p0dxD/espWatchOS/3dmodel/bme280.png

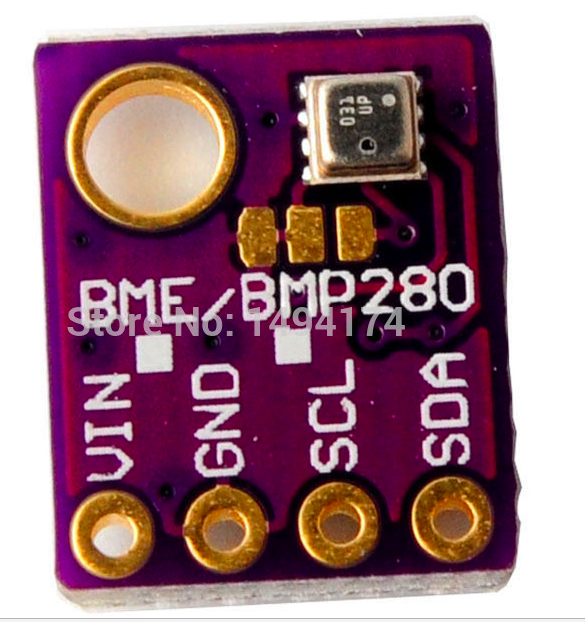
3dmodel/bme280.png
