p0dxD/espWatchOS/3dmodel/eink.png

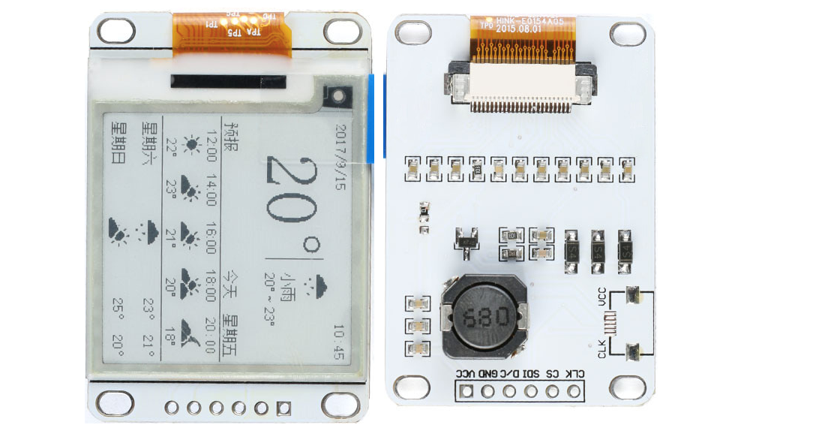
3dmodel/eink.png
