p0dxD/espWatchOS/3dmodel/eink_back.png

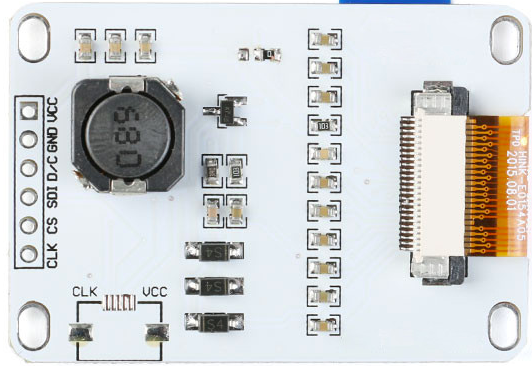
3dmodel/eink_back.png
