p0dxD/espWatchOS/3dmodel/eink_front.png

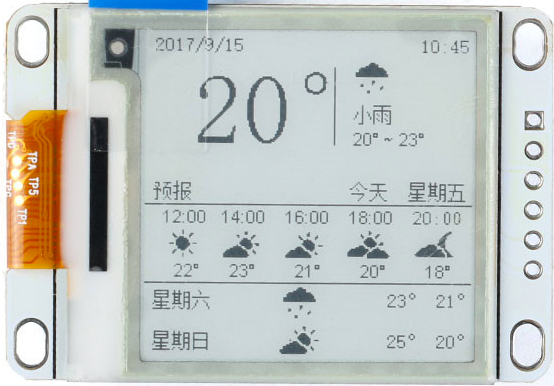
3dmodel/eink_front.png
