p0dxD/espWatchOS/3dmodel/esp.png

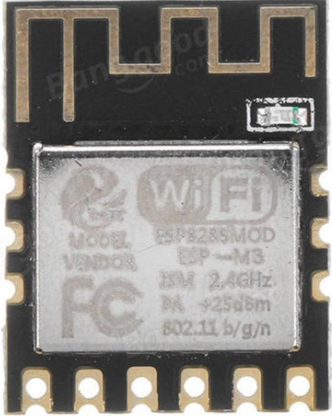
3dmodel/esp.png
