p0dxD/espWatchOS/code/assets/face.bmp

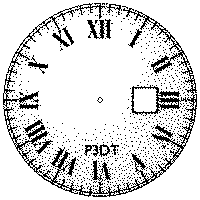
code/assets/face.bmp
