p0dxD/espWatchOS/code/assets/face.png

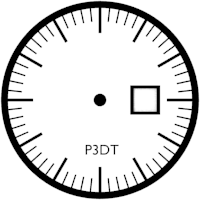
code/assets/face.png
