p0dxD/espWatchOS/3dmodel/wristband-15cm.stl

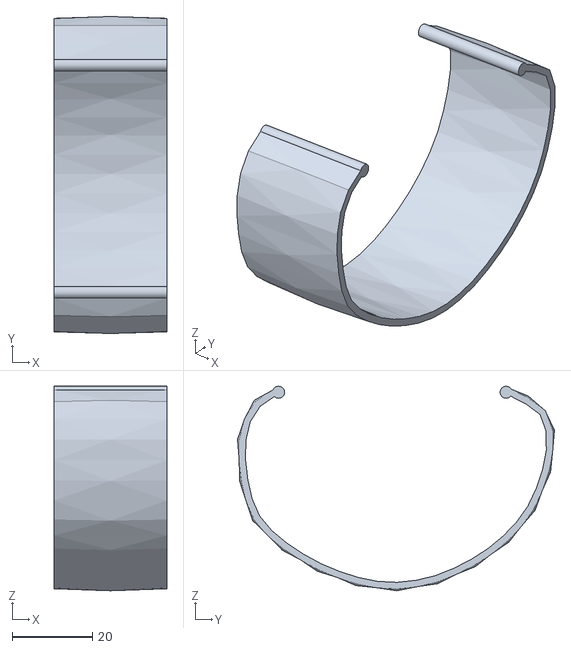
[picture p13: CAD file, 2018-08-28]
3dmodel/wristband-15cm.stl
28.0 x 78.8 x 50.9
