p0dxD/espWatchOS/3dmodel/espWatch-v4.stl

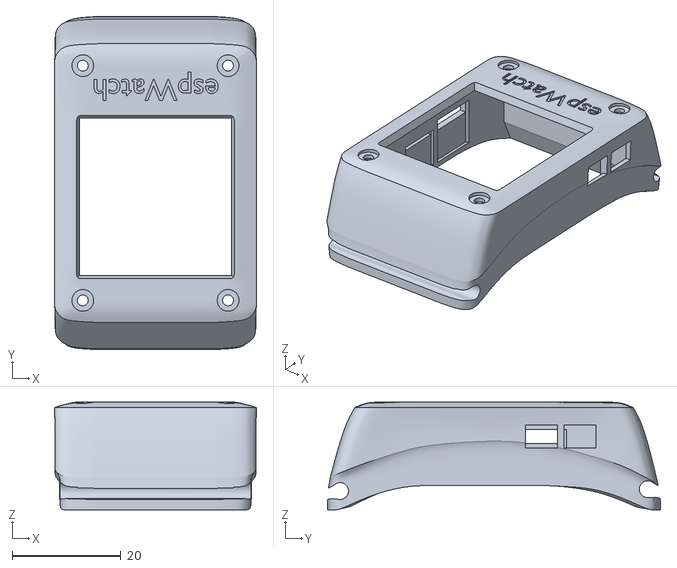
[picture p14: CAD file, 2018-08-28]
3dmodel/espWatch-v4.stl
37.2 x 61.2 x 19.8
