p0dxD/espWatchOS/3dmodel/bottom cover.stl

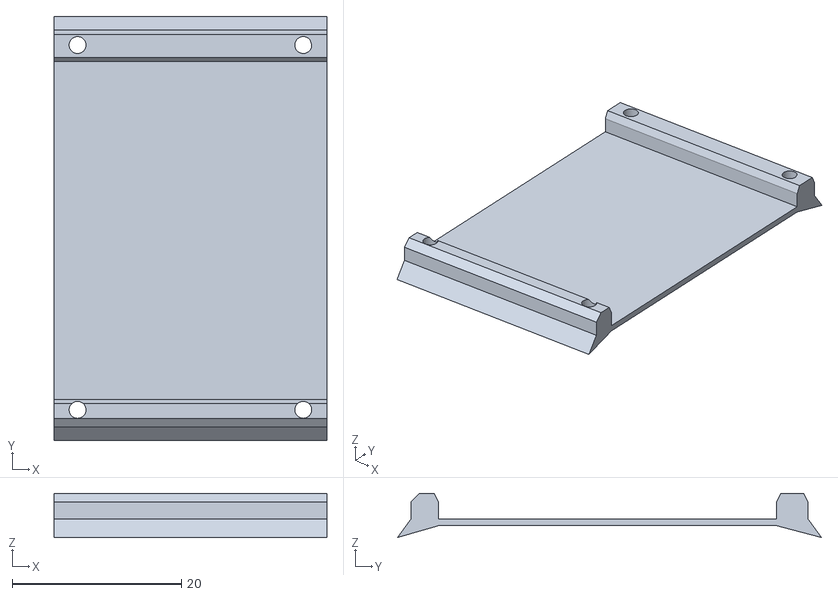
[picture p15: CAD file, 2018-08-28]
3dmodel/bottom cover.stl
32.2 x 50.1 x 5.20
