p0dxD/espWatchOS/3dmodel/buttons.stl

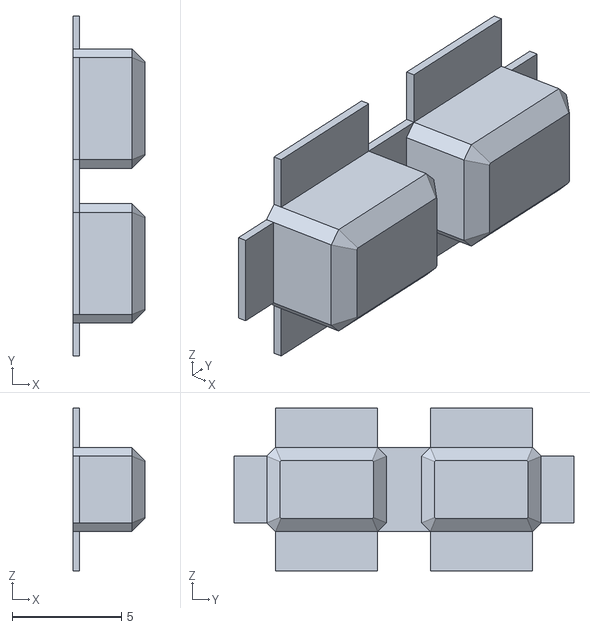
[picture p16: CAD file, 2018-08-28]
3dmodel/buttons.stl
3.30 x 15.6 x 7.45
