p0dxD/espWatchOS/3dmodel/espW-buttons.stl

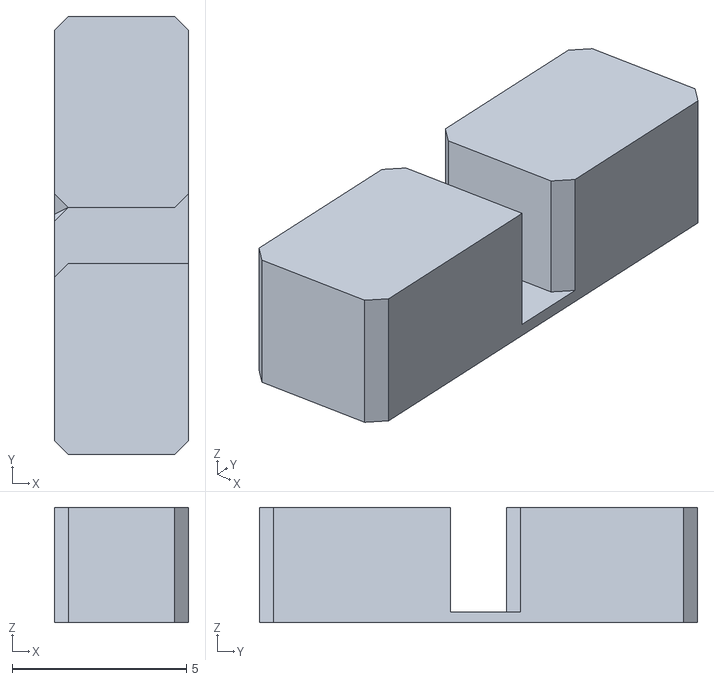
[picture p17: CAD file, 2018-08-28]
3dmodel/espW-buttons.stl
3.85 x 12.6 x 3.30
