p0dxD/espWatchOS/3dmodel/wristband.stl

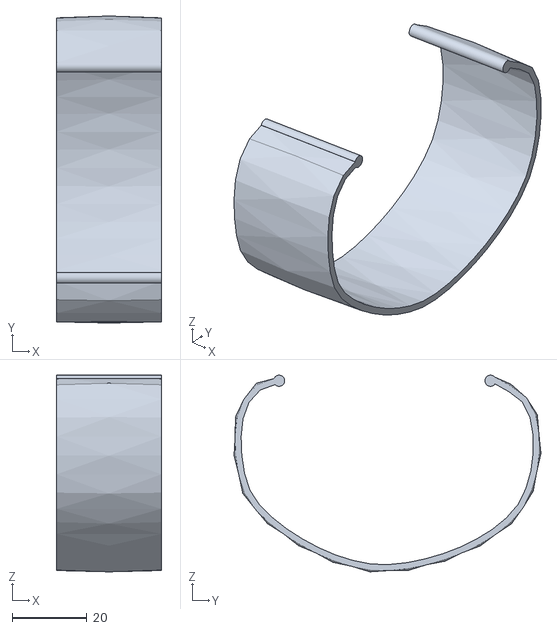
[picture p18: CAD file, 2018-08-28]
3dmodel/wristband.stl
28.0 x 82.2 x 52.7
