p0dxD/espWatchOS/3dmodel/espWatch.stl

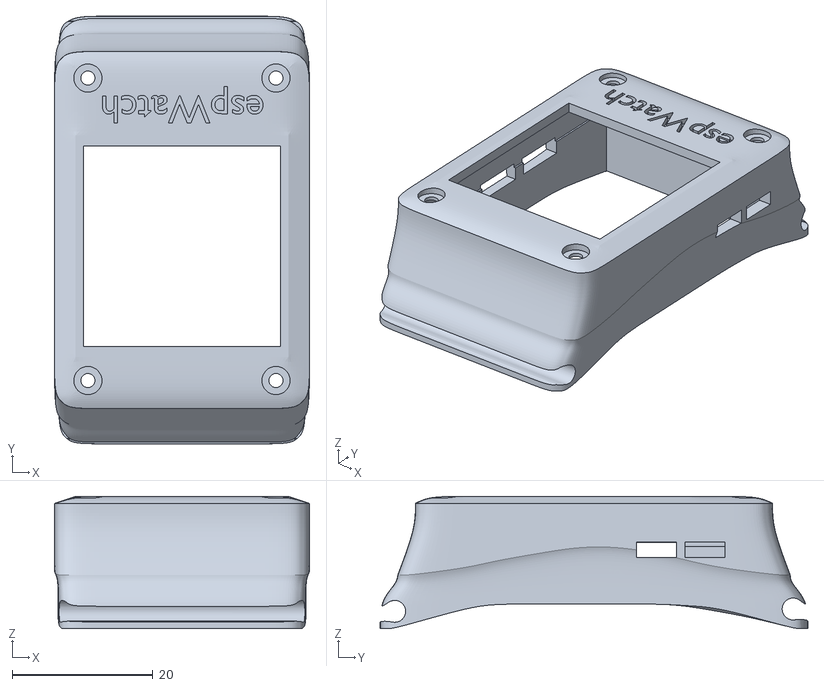
[picture p19: CAD file, 2018-08-28]
3dmodel/espWatch.stl
36.2 x 60.7 x 18.8
