p0dxD/espWatchOS/3dmodel/espWatch-v2.stl

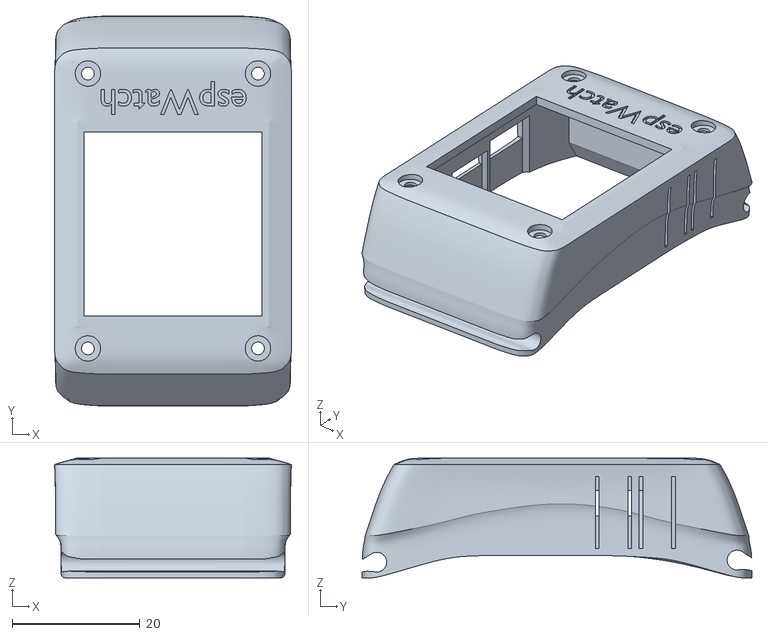
[picture p20: CAD file, 2018-08-28, an earlier design]
3dmodel/espWatch-v2.stl
37.2 x 61.2 x 18.8
