p0dxD/espWatchOS/(list of files, cad)

Other CAD files:
3dmodel/espWatch-v3.stl
code/assets/iconds.blend
code/assets/watchface.blend
