p0dxD/espWatchOS/pcb/espWatch/espWatch.kicad_pcb

## KiCad design pcb/espWatch/espWatch.kicad_pcb (2018-09-04)

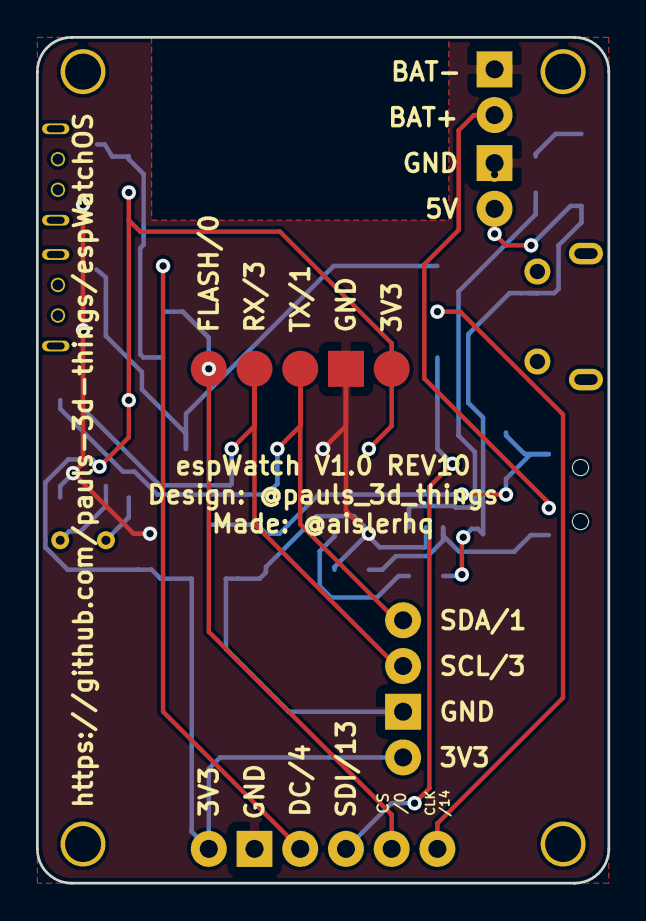
[picture p21: board espWatch.kicad_pcb from above]

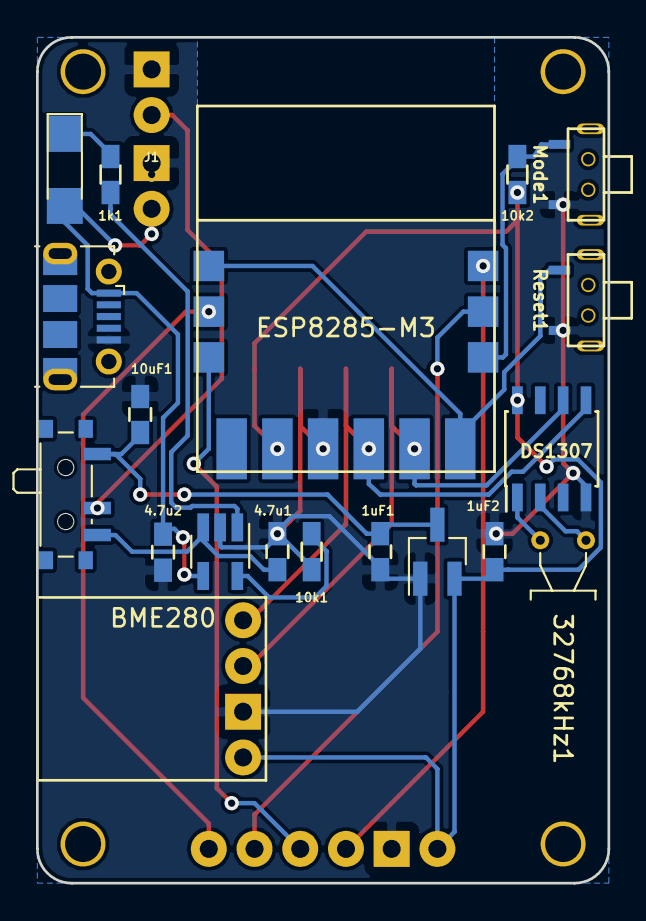
[picture p22: board espWatch.kicad_pcb from below]

Board: 2 copper layers, 31.8 x 47.0 mm, 23 parts (20 on the bottom side), 19 nets.

Parts:
1k1: R_LED; R_0603_HandSoldering_narrow
1uF1: Cin; C_0603_HandSoldering_narrow
1uF2: Cout; C_0603_HandSoldering_narrow
4.7u1, 4.7u2: C_Small; C_0603_HandSoldering_narrow
10k1: R_PROG; R_0603_HandSoldering_narrow
10k2: R_Mode; R_0603_HandSoldering_narrow
10uF1: CAP_VIN; C_0603_HandSoldering_narrow
32768kHz1: CRYSTAL; Crystal_AT310_D3.0mm_L10.0mm_Horizontal_1EP_style1
BME280: BME280
CHG/ON1: SWITCH; SW_SPDT_PCM12
D1: LED_Status; LED_1206_HandSoldering_wide
ESP8285-M3: esp8285-m3
J1: BAT; Pin_Header_Straight_1x02_Pitch2.54mm
J2: USB_A; USB_Micro-B_Molex-105017-0001
J3: DISPLAY; Pin_Header_Straight_1x06_Pitch2.54mm
MCP73831: mcp73831; SOT-23-5_HandSoldering
Mode1: SW_MODE; button_side_smd
Programmer1: Programmer; Pin_Header_Straight_1x05_Pitch2.54mm
Reset1: SW_RST; button_side_smd
Solar1: Solar; Pin_Header_Straight_1x02_Pitch2.54mm
U4: DS1307+; SOIC-8_3.9x4.9mm_P1.27mm
U5: MCP1700-3302E_SOT23; SOT-23_Handsoldering

Connections:
+3V3: 1uF2.1, 10k2.1, BME280.1, ESP8285-M3.5, J3.6, Programmer1.5, U4.8, U5.2
+3V8: 1uF1.1, 10uF1.1, CHG/ON1.1, U5.3
+5V: 4.7u2.1, D1.2, J2.1, MCP73831.4, Solar1.1
/BAT+: CHG/ON1.2, J1.1
/BTN_MODE: 10k2.2, ESP8285-M3.10, Mode1.1
/CLK: ESP8285-M3.2, J3.1
/CS: ESP8285-M3.11, J3.2, Programmer1.1
/DC: ESP8285-M3.12, J3.4
/RST: ESP8285-M3.1, ESP8285-M3.9, Reset1.1
/SCL: BME280.3, ESP8285-M3.8, Programmer1.2, U4.6
/SDA: BME280.4, ESP8285-M3.7, Programmer1.3, U4.5
/SDI: ESP8285-M3.3, J3.3
/VBAT: 4.7u1.1, CHG/ON1.3, MCP73831.3
GND: 1uF1.2, 1uF2.2, 4.7u1.2, 4.7u2.2, 10k1.1, 10uF1.2, BME280.2, ESP8285-M3.6, J1.2, J2.4, J3.5, MCP73831.2, Mode1.2, Programmer1.4, Reset1.2, Solar1.2, U4.4, U5.1
unnamed: 1k1.1, MCP73831.1
unnamed: 1k1.2, D1.1
unnamed: 10k1.2, MCP73831.5
unnamed: 32768kHz1.1, U4.1
unnamed: 32768kHz1.2, U4.2
