p0dxD/espWatchOS/(commit log)

2018-08-09 Use rtc module
    Save more power during sleep
2018-08-09 Test power saving
2018-08-10 Button test on gpio2
2018-08-10 Add watchfaces
    [watchface.blend]
2018-08-10 Add roman watchface
    [watchface.blend]
2018-08-10 Update blend
    [watchface.blend]
2018-08-10 Add icons and logo
    [iconds.blend]
2018-08-28 Add 3d model, refactor structure, cleanup watchfaces
    [bottom cover.stl, buttons.stl, espW-buttons.stl, espWatch-v2.stl, espWatch-v3.stl, espWatch-v4.stl, espWatch.stl, iconds.blend]
2018-09-02 Add SensorHistory class
2018-09-04 Add KiCad files, update Readme.md
    [espWatch.kicad_pcb, espWatch.sch, espWatch_old.kicad_pcb]
